orange9947/airobot/(commit log)

2026-07-13 feat(protocol): add SPI mailbox foundation and simulator
2026-07-13 feat(stm32): implement SPI robot controller firmware
2026-07-13 feat(esp32): add web and LLM robot controller
2026-07-14 fix(esp32): support MicroPython deque semantics
    [web_service.py]
2026-07-14 fix(hardware): stabilize STM32 bring-up and SPI timing
    [app.c, device_service.py, spi_mailbox.c]
2026-07-14 fix(stm32): harden W25Q initialization
    [w25q.c]
2026-07-14 feat(stm32): support rotation-only EC11 control
2026-07-14 fix(stm32): service SPI between OLED pages
2026-07-14 fix(esp32): keep credential setup responsive
    [config_service.py, network_service.py, web_service.py]
2026-07-14 fix(ai): make tool handoff relay-compatible
2026-07-14 fix(robot): make login atomic and move OLED status
    [test_status_label.c, web_service.py]
2026-07-14 docs: design SPI safety session recovery
2026-07-14 docs: plan SPI safety session recovery
2026-07-14 fix(safety): recover SPI supervision from valid traffic
    [test_robot_core.c]
2026-07-14 docs: design first left-wheel bring-up
2026-07-14 docs: plan first left-wheel bring-up
2026-07-15 feat(stm32): add power-safe expression resources
2026-07-15 feat(esp32): add resilient resource upload service
2026-07-15 fix(web): harden local control sessions
    [web_service.py]
2026-07-15 feat(resources): add sample OLED expressions
2026-07-15 fix(web): accept mobile HTTP header values
    [web_service.py]
2026-07-15 fix(web): queue burst HTTP connections
    [web_service.py]
2026-07-15 docs: design OpenAI relay output compatibility
2026-07-15 fix(openai): accept completed Responses SSE
    [http_client.py]
2026-07-15 docs: design zero-step wheel power isolation
2026-07-15 fix(stm32): keep zero-step wheel deenergized
    [test_robot_core.c]
2026-07-15 docs: design loaded motor voltage diagnostic
2026-07-15 docs: plan loaded motor voltage diagnostic
2026-07-15 docs: design right wheel phase order diagnostic
2026-07-15 docs: plan right wheel phase order diagnostic
2026-07-15 docs: design final right wheel phase order test
2026-07-15 docs: design bounded coil voltage diagnostic
2026-07-15 docs: plan bounded coil voltage diagnostic
2026-07-15 feat(stm32): add bounded coil diagnostic service
2026-07-15 feat(stm32): integrate safe coil diagnostics
2026-07-15 feat(esp32): support internal coil diagnostics
